Gaowt-debug/diankong/机器人本体代码分析.md

注：整体设计思路 和 代码框架部分 由ai生成

**机器人部分**

**整体设计思路**

本项目基于 STM32F103，实现了一个视觉引导的自动瞄准云台，应用于竞技场景中的能量机关击打任务。

追踪系统核心逻辑分为四个阶段（Step1~4）：

螺旋扫描：云台按预定轨迹扫描，直至视觉模块检测到目标

圆心锁定：利用视觉返回的装甲板圆心坐标，将云台对准能量机关旋转中心

参数标定：主动移动云台，测量像素位移与PWM输出的比例关系（Kx/Ky），同时测量目标圆周半径

预测追踪：采用卡尔曼滤波 + 圆周运动模型 + 超前预测 + 前馈+残差PID的复合控制策略，实现稳定瞄准

同时系统集成了底盘移动、取球/吃球机构、遥控指令解析等功能，形成完整的机器人战斗逻辑。

**代码框架**
1. 硬件抽象层
模块	功能
stm32f10x.h	标准外设库
Delay / OLED	调试延时与显示
usart	双串口：USART1接视觉模块，USART2接遥控器
pca9685	16路PWM舵机驱动（云台+执行机构）
tb6612	电机驱动（麦克纳姆轮底盘+吃球机构）
other / hc-sr04	辅助传感器
1. 模块初始化 all_init()
OLED、双串口、定时器TIM3（1ms节拍）

PCA9685初始化，云台归中（450,510）

TB6612底盘初始化

激光发射器初始化（PA15，默认关闭）

3. 后台中断服务
text
TIM3_IRQHandler (1ms)
├── 20ms子任务
│   ├── 追踪状态下输出云台PWM
│   ├── 取球舵机位置缓动（限速12/7步）
│   └── 轮询4个舵机的目标/当前位置更新
└── 1s子任务
    └── hit_wait 看门狗递减（目标丢失倒计时）

USART1_IRQHandler
├── 视觉数据包解析（ASCII格式：sx,sy,r,cx,cy\n）
├── Step2~4 全部追踪逻辑（核心计算在此中断内完成）
└── 丢失目标（'A'帧）处理

USART2_IRQHandler
├── 角度数据包解析（[x,x,x,x]格式 → remote_agl[4]）
└── 遥控指令分发（move/eat/take/云台手动等）
4. 前台主循环 main()
仅处理非实时的状态变化响应：

底盘运动模式切换（move_mode）

吃球电机速度切换（eat_mode）

取球舵机位置/伸缩/旋转控制（take_dir, take_revolve, eat_pull_mode）

所有云台追踪计算均在USART1中断中完成

**重点设计部分**

1. 追踪代码的总体设计，看门狗以及从寻找，测定比例，测定绝对位置，算法追踪的步骤
2. 机械臂运动逻辑，限速和限位，控制模式的灵活转换，和预设模式按键
3. 其余简单舵机，电机的操作逻辑优化，减少占用同时保障灵敏度

**方案启发来源**

收集铲斗部分：吸轮方案是我通过短视频得到的灵感，结合了机械组最初的铲斗方案，并经过我的优化和调试，包括铲斗臂倾倒设计，吸轮的不固定设计，机械运动结构和吸轮材质与安装方式
在后续测试中我发现铲斗臂运动到最高时不会自动停下而造成损坏，为其额外添加了简单的位置传感器（两个杜邦线被碰到后分开），将限位信号传给单片机通过代码限制过度升起

至于视觉追踪部分的代码，第三版以前几乎全部是自己在一次次调试中得到的方案，我的大部分时间都花在这部分（但最后虽然视觉队员已经将识别尽力做好但我这边效果仍然极差，无奈在比赛上弃用）

其余操作方案大部分是在机甲杯之前的一些活动中积累经验和代码的运用

**难点问题和解决方案**

1. 舵机驱动芯片的不稳定输出，这个问题在后半段机械臂上显现，机械臂时不时的抽搐，后续从头出发逐个梳理检测问题所在，最后确定问题出现在单片机信号输出和驱动芯片输出之间，可能是i2c通信或驱动芯片损坏，再进一步排查中我最终禁用了所有奇数占空比，恢复正常
2. 蓝牙主从通信乱码，波特率出错
3. 机械臂操作部分由于操作方式更新出现的问题，设计了兼容原代码的操作杆逻辑，保障增加遥控器后的稳定，以及必要时候原方案的可用性
4. 大部分问题出现在软件电控以外，这里不再一一叙述

**AI生成部分**

1. 代码的美化和注释
2. 第三版以后的能量机关预测解析（卡尔曼滤波等）部分代码，校准和状态机步骤变化不大
3. 遥控器数据包解析代码
4. pca9685舵机驱动底层通信以及其他部分模块化代码 
5. 上述 整体设计思路 和 代码框架部分 介绍
